mcore1976/antispy-jammer/esp/esp8266-wemos-D1-MINI-PINOUT.png

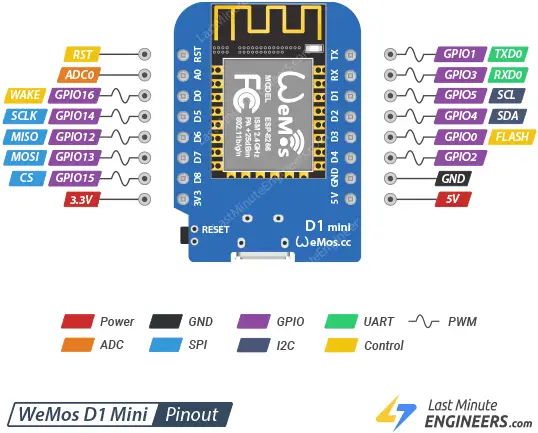
esp/esp8266-wemos-D1-MINI-PINOUT.png
