mcore1976/antispy-jammer/arduino-mic-supresor-ultrasonic-RP2040-zero-PWM-no-AD9833-TC4420-IRF4115-coils.png

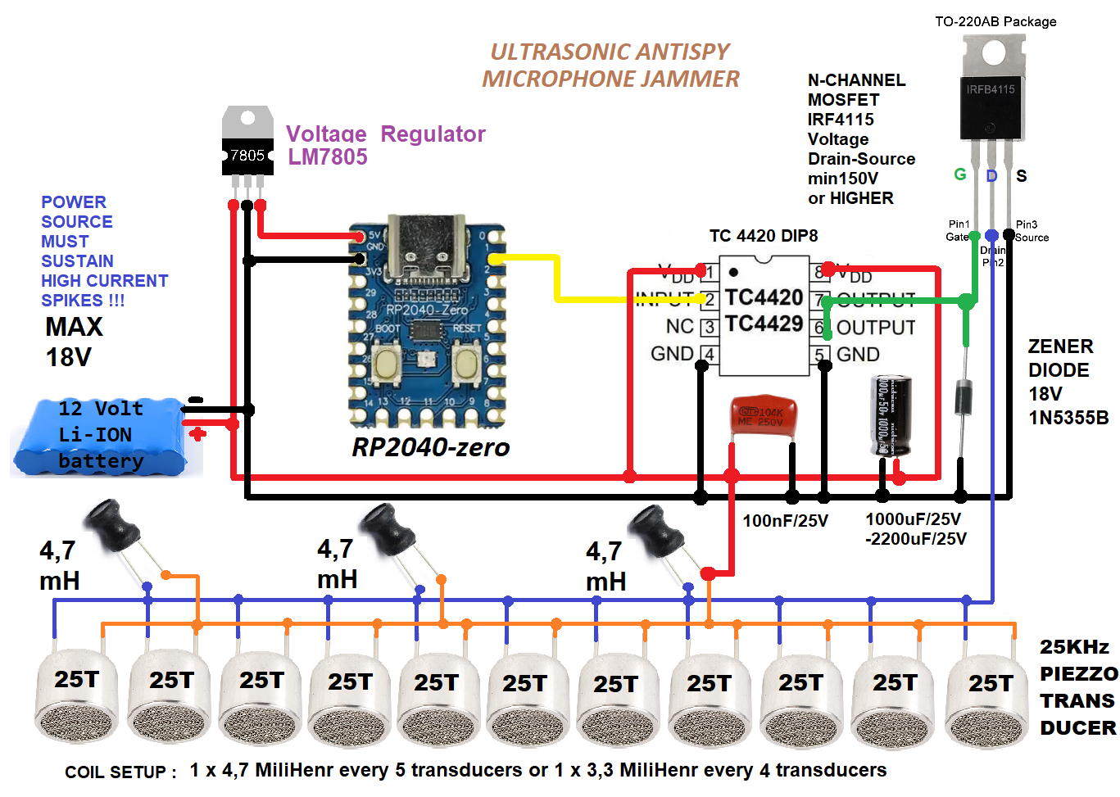
arduino-mic-supresor-ultrasonic-RP2040-zero-PWM-no-AD9833-TC4420-IRF4115-coils.png
