mcore1976/antispy-jammer/antispy-jammer-H-bridge-RP2040-PWM-IR2103-IRF4115-PCB-view.PNG

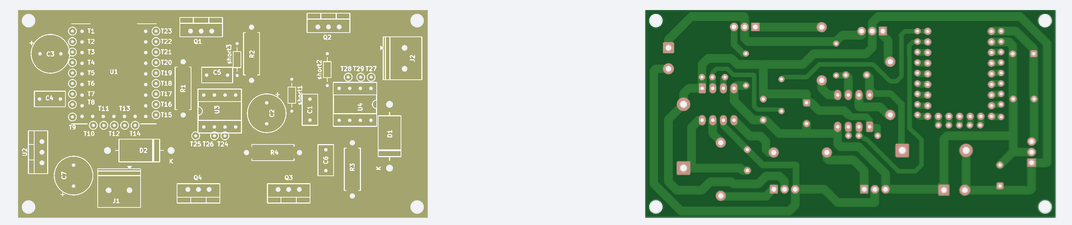
antispy-jammer-H-bridge-RP2040-PWM-IR2103-IRF4115-PCB-view.PNG
