mcore1976/antispy-jammer/antispy-jammer-H-bridge-RP2040-PWM-IR2104-IRF4115.PNG

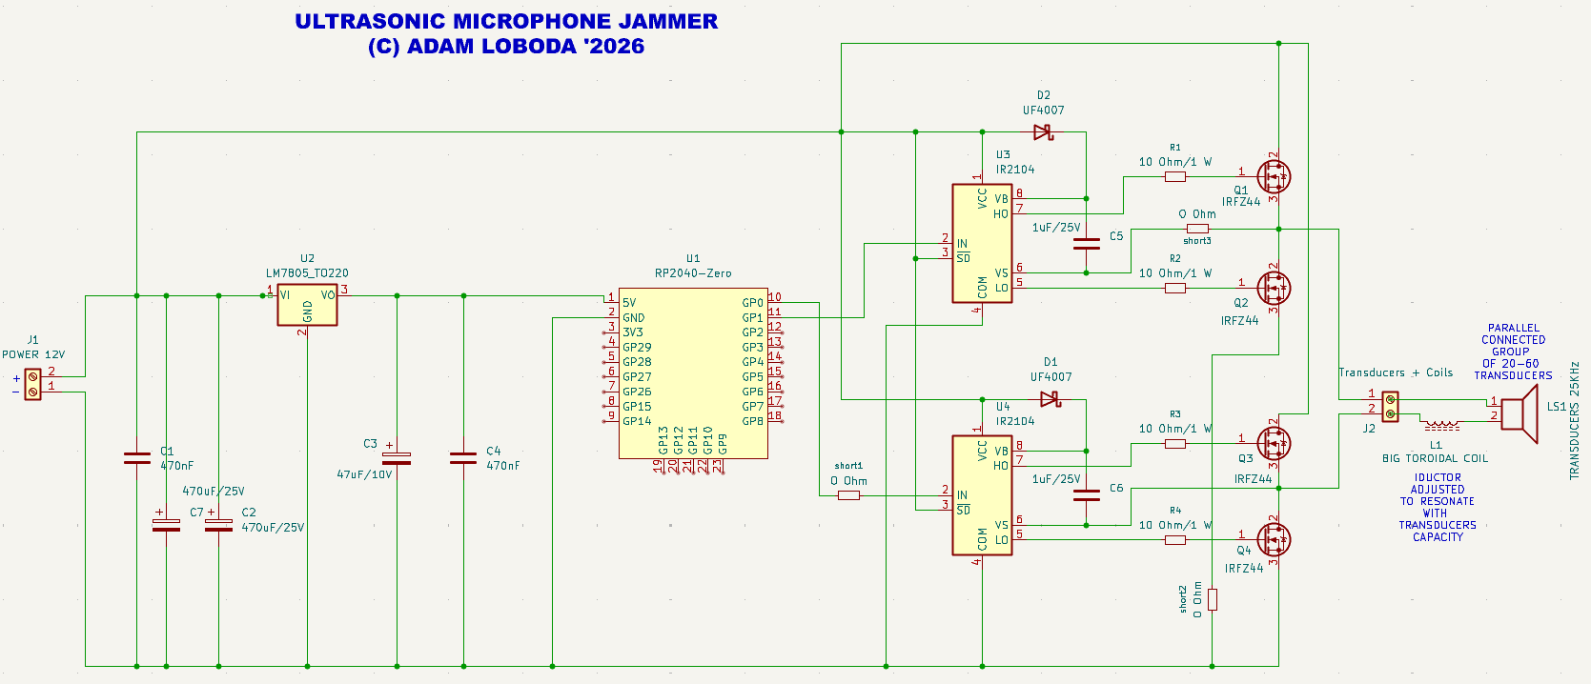
antispy-jammer-H-bridge-RP2040-PWM-IR2104-IRF4115.PNG
