mcore1976/antispy-jammer/arduino-mic-supresor-ultrasonic-RP2040-zero-TC4420-IRF4115-coils.png

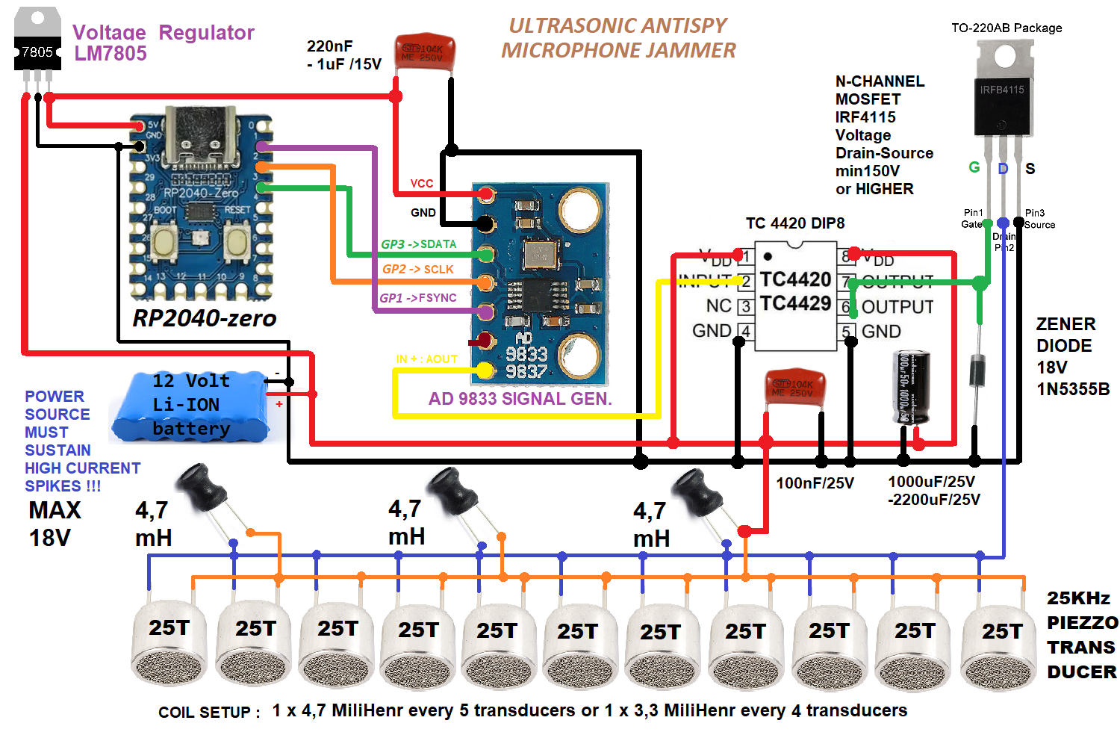
arduino-mic-supresor-ultrasonic-RP2040-zero-TC4420-IRF4115-coils.png
