mcore1976/antispy-jammer/arduino-mic-supresor-ultrasonic-RP2040-zero-TPA3116-IRF-coils.png

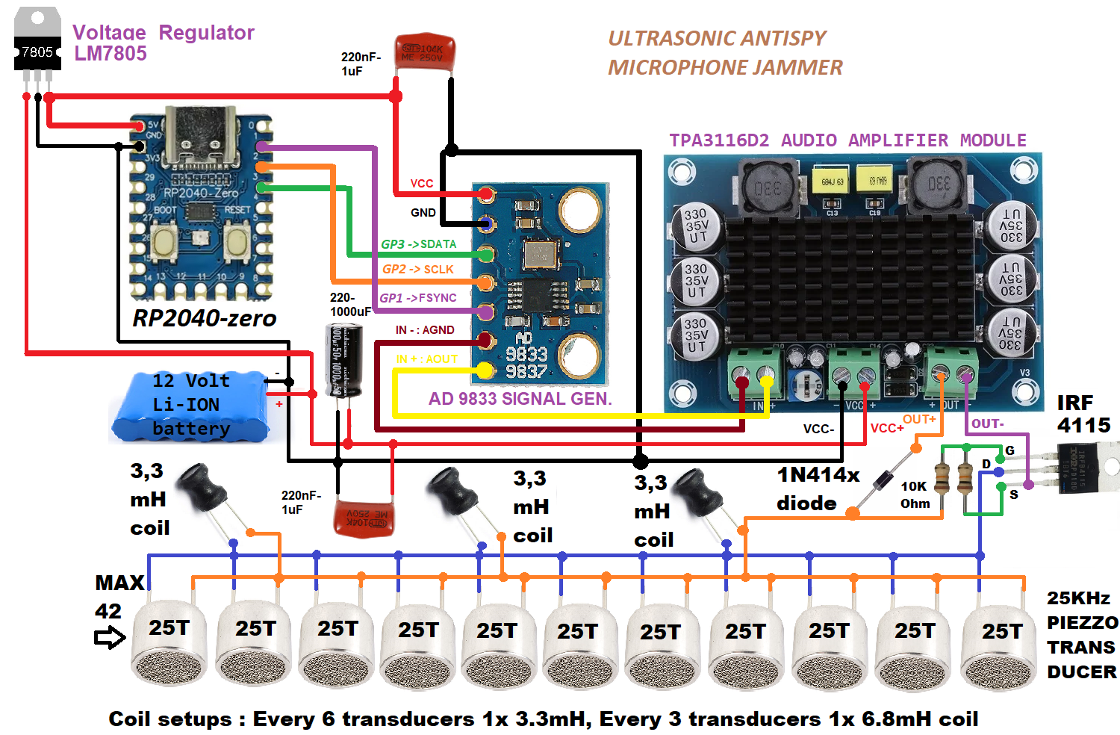
arduino-mic-supresor-ultrasonic-RP2040-zero-TPA3116-IRF-coils.png
