mcore1976/antispy-jammer/arduino-mic-supresor-ultrasonic-RP2040-zero.png

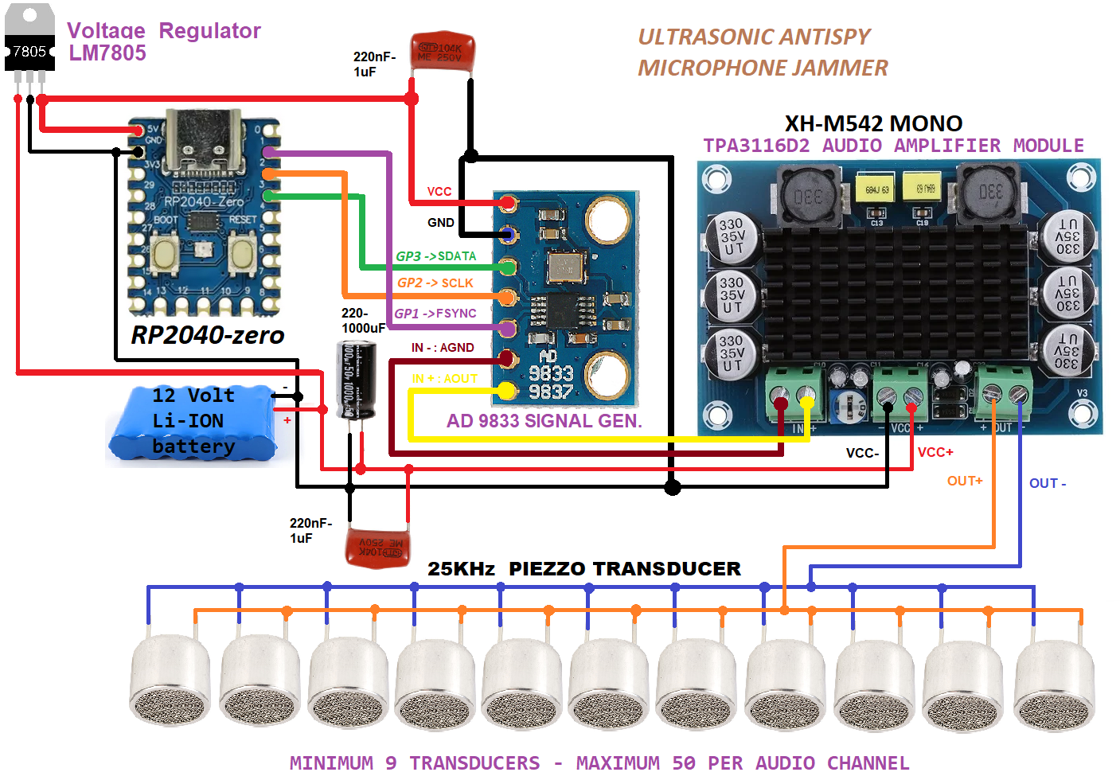
arduino-mic-supresor-ultrasonic-RP2040-zero.png
