mcore1976/antispy-jammer/attiny/antispy-jammer-enhanced-schematic.png

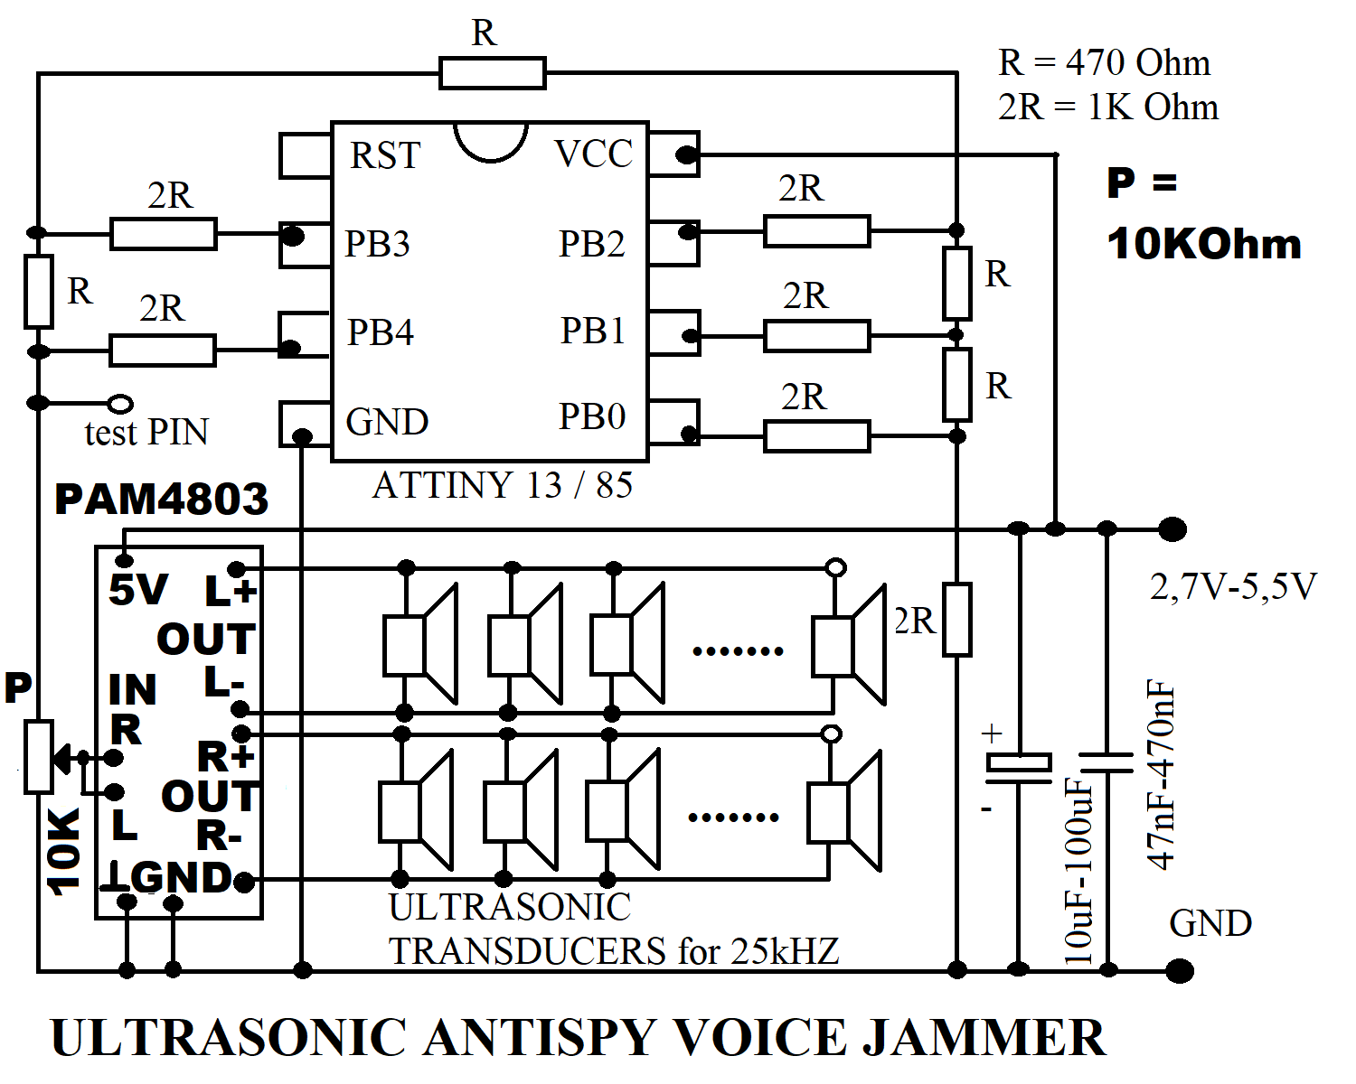
attiny/antispy-jammer-enhanced-schematic.png
