mcore1976/antispy-jammer/attiny/antispy-jammer-schematic.png

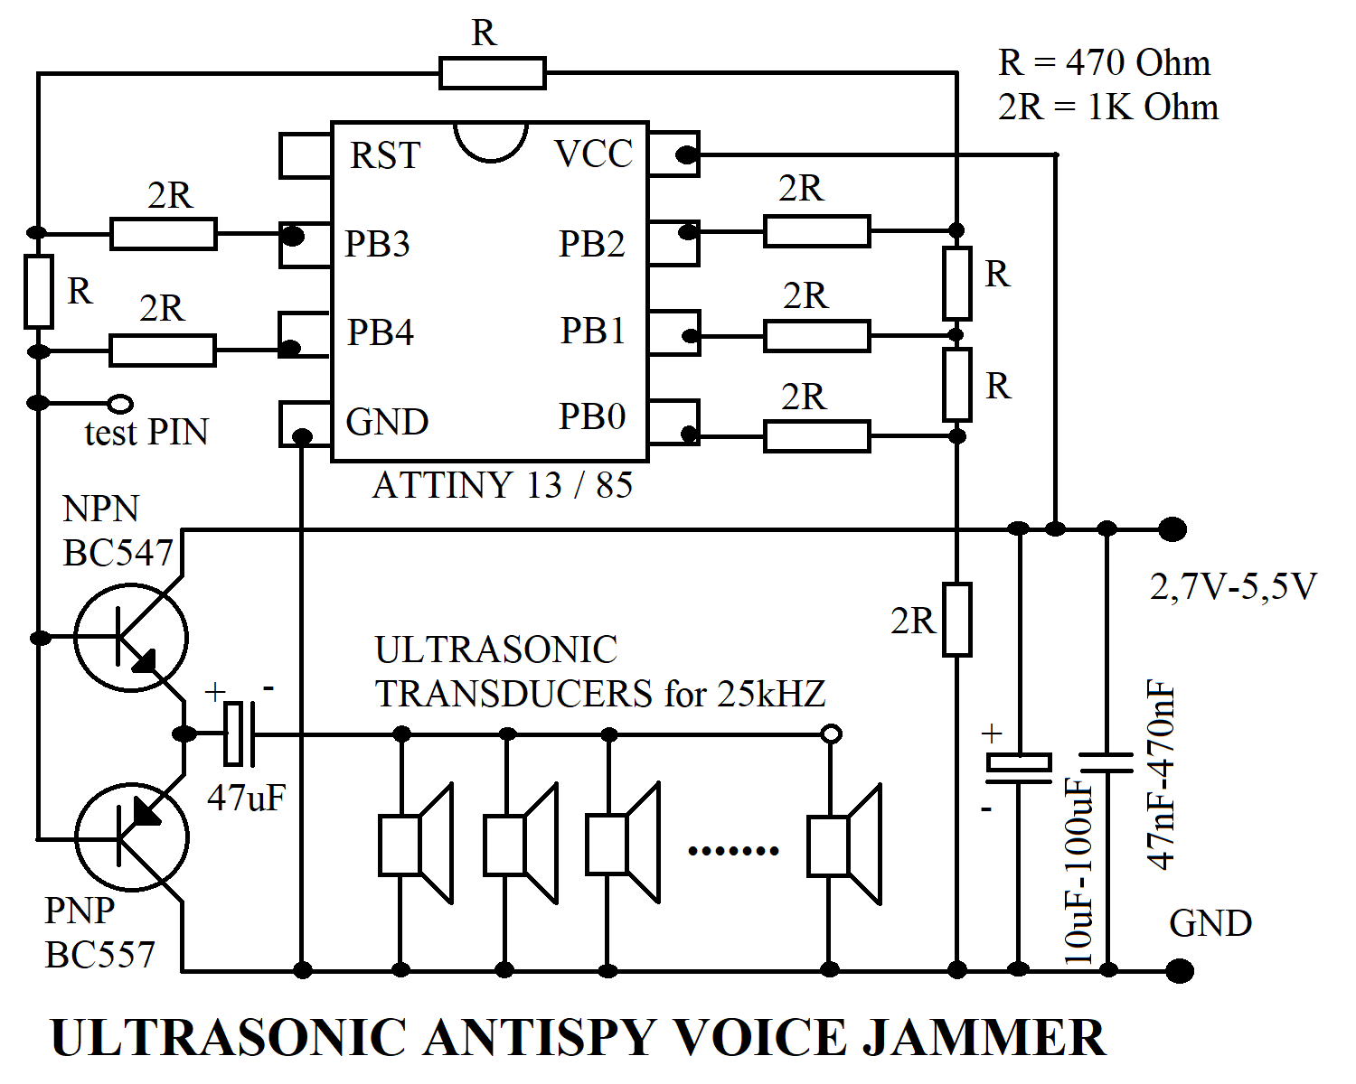
attiny/antispy-jammer-schematic.png
