mcore1976/antispy-jammer/attiny/arduino-mic-supresor-ultrasonic-ATTINY85-TC4420-IRF4115-coils.png

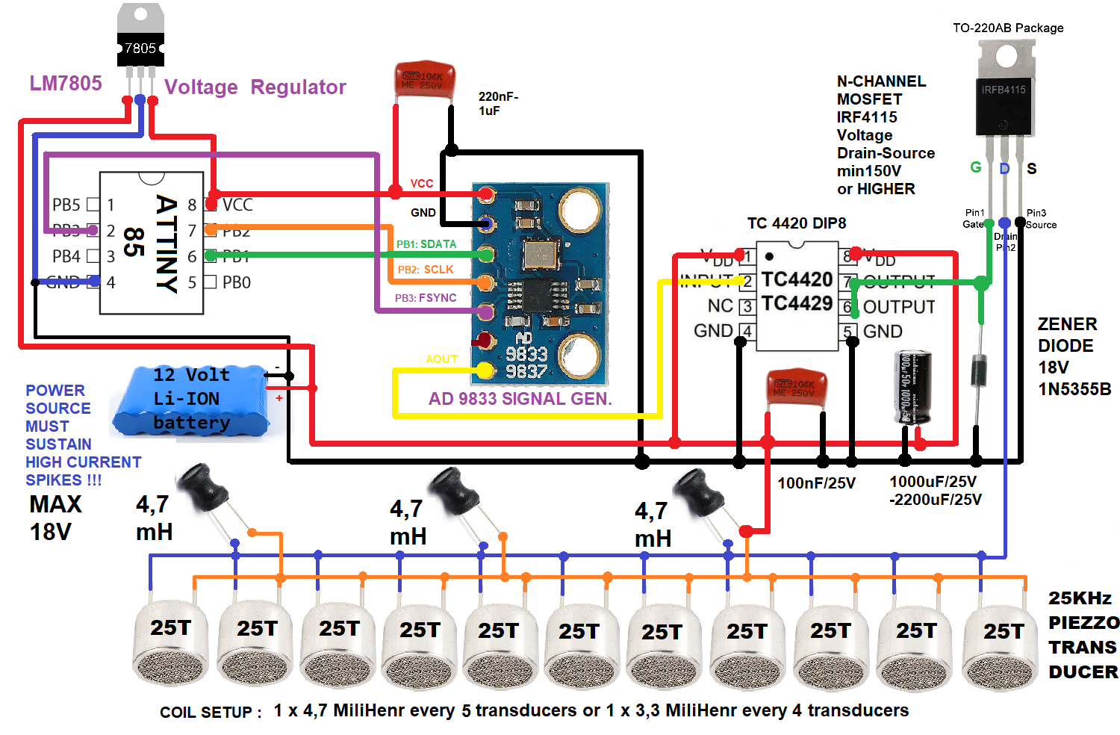
attiny/arduino-mic-supresor-ultrasonic-ATTINY85-TC4420-IRF4115-coils.png
