mcore1976/antispy-jammer/attiny/arduino-mic-supresor-ultrasonic-v2-ATTINY85.png

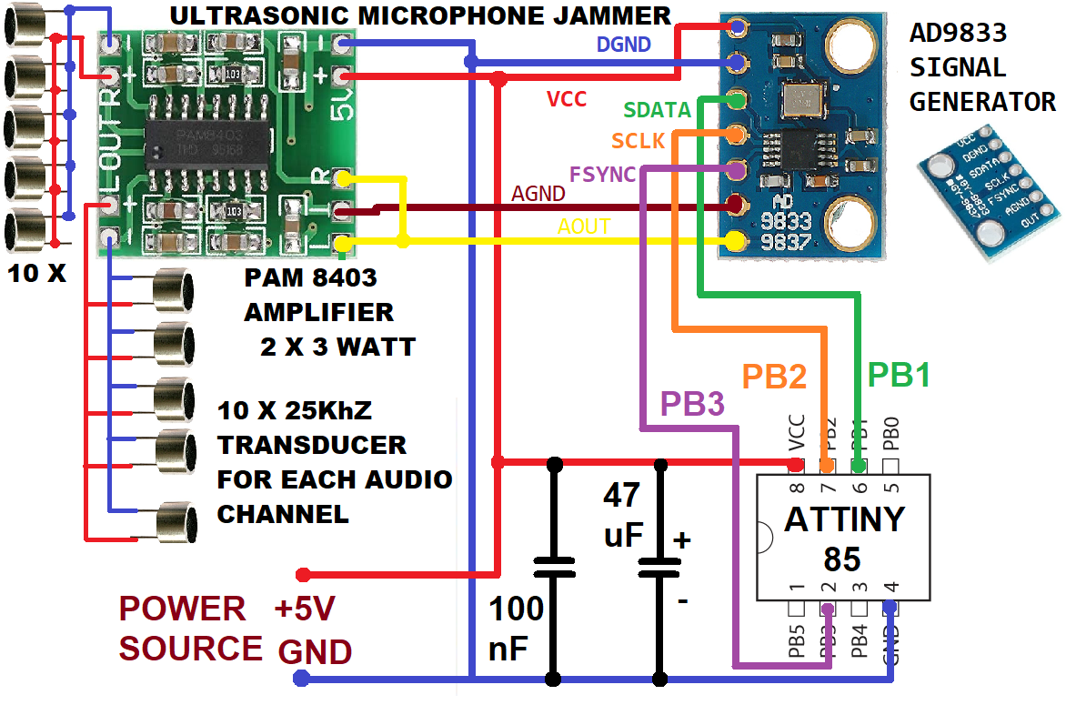
attiny/arduino-mic-supresor-ultrasonic-v2-ATTINY85.png
