mcore1976/antispy-jammer/attiny/arduino-mic-supresor-ultrasonic-v2.png

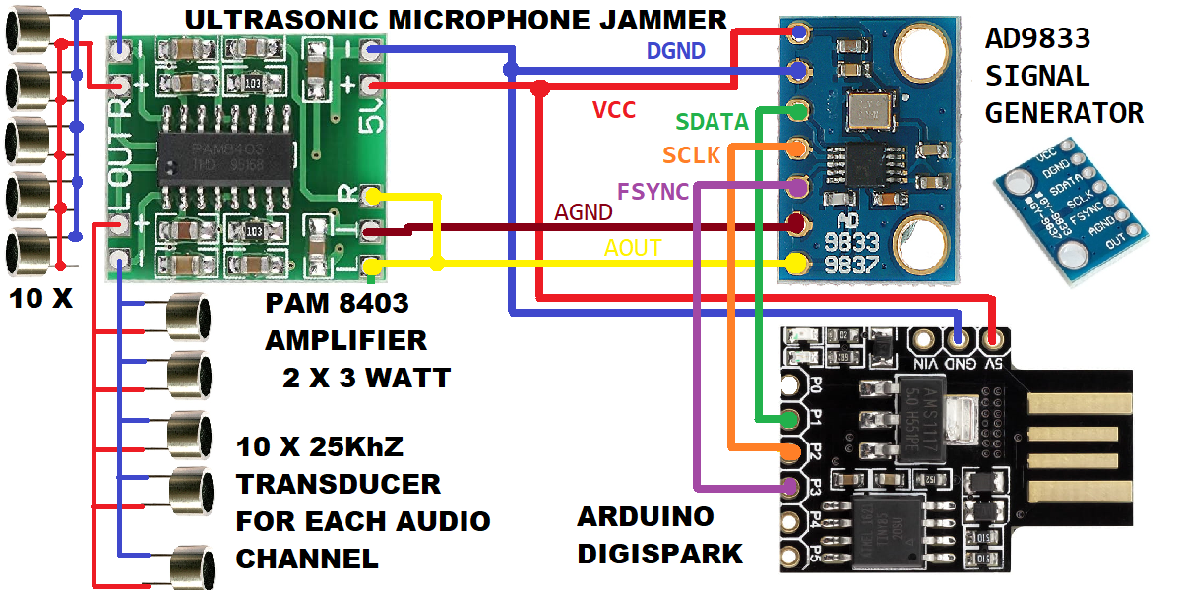
attiny/arduino-mic-supresor-ultrasonic-v2.png
