mcore1976/antispy-jammer/attiny/arduino-mic-supresor-ultrasonic-v3-ATTINY85-TPA3116-IRF-coils.png

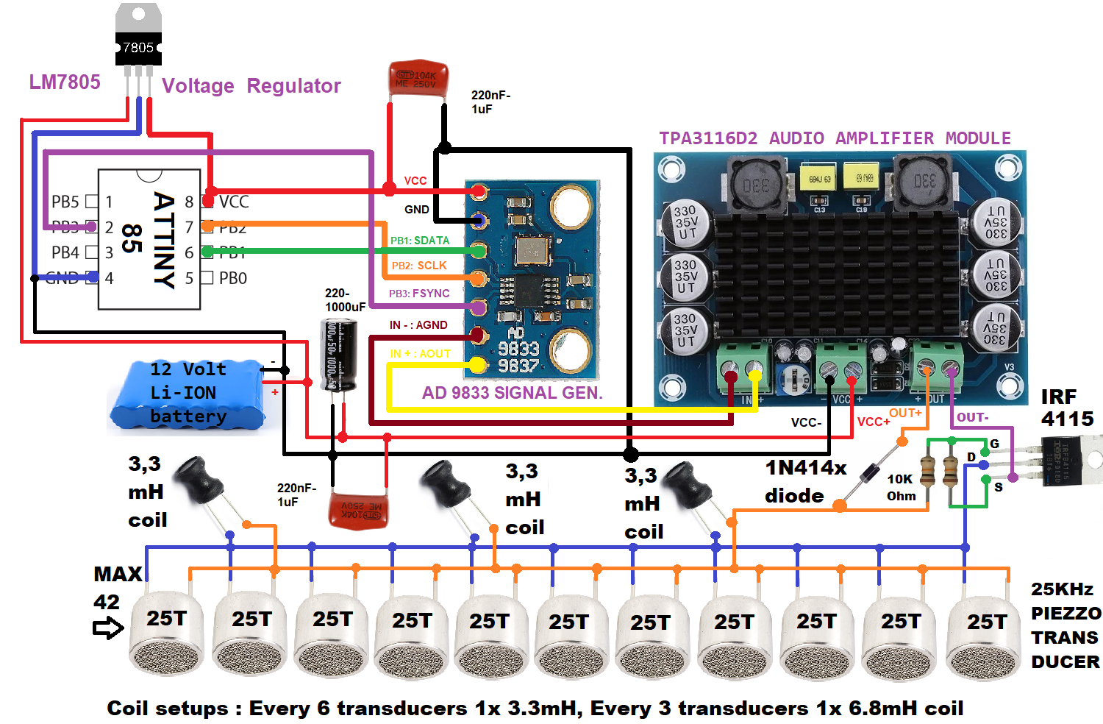
attiny/arduino-mic-supresor-ultrasonic-v3-ATTINY85-TPA3116-IRF-coils.png
