mcore1976/antispy-jammer/attiny/arduino-mic-supresor-ultrasonic.png

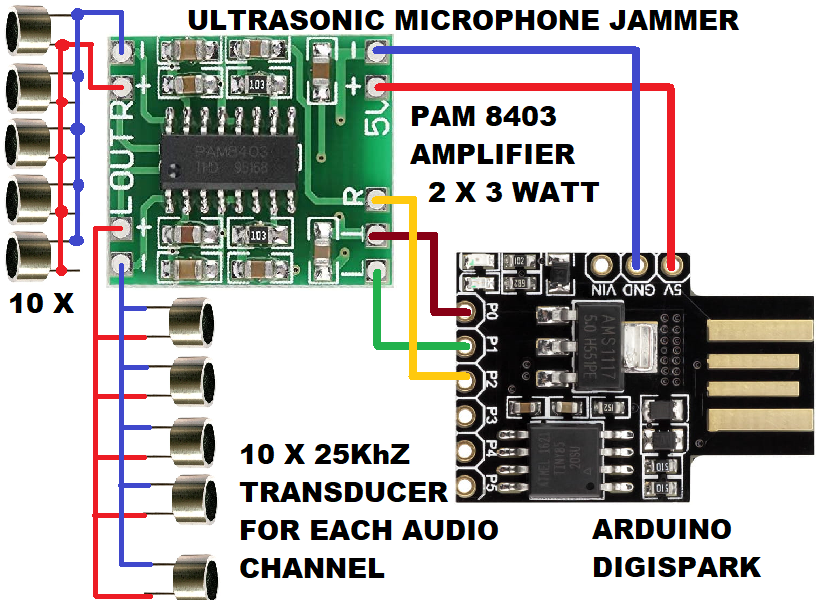
attiny/arduino-mic-supresor-ultrasonic.png
