mcore1976/antispy-jammer/attiny/mic-jammer-AD9833-TPA3116D2-IRF-coils.png

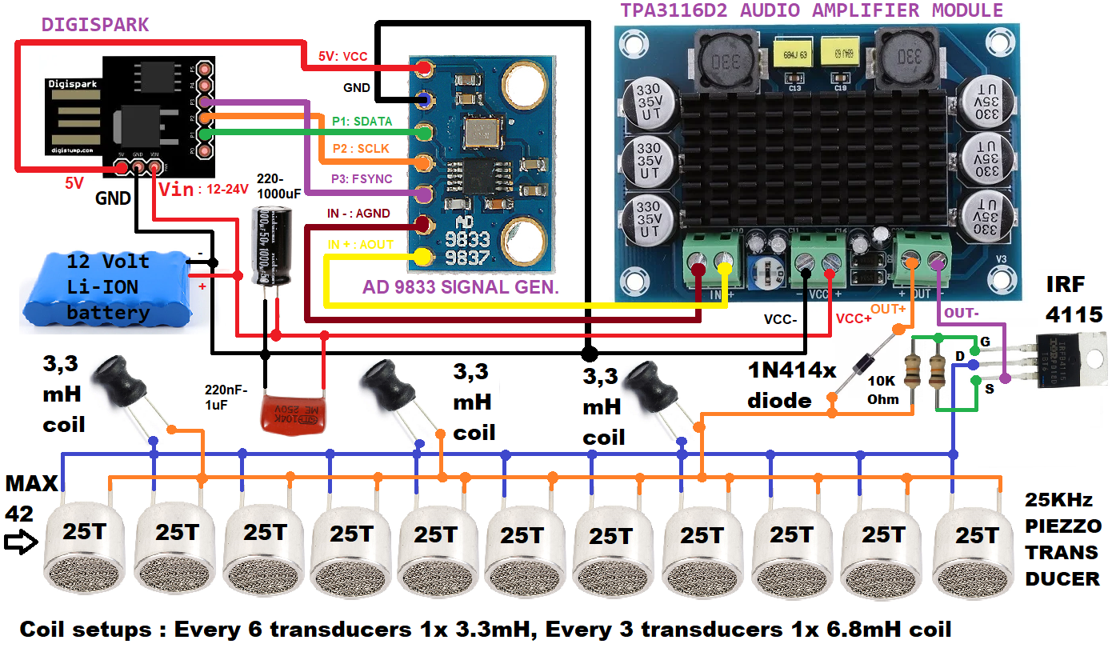
attiny/mic-jammer-AD9833-TPA3116D2-IRF-coils.png
