mcore1976/antispy-jammer/attiny/mic-jammer-AD9833-TPA3116D2.png

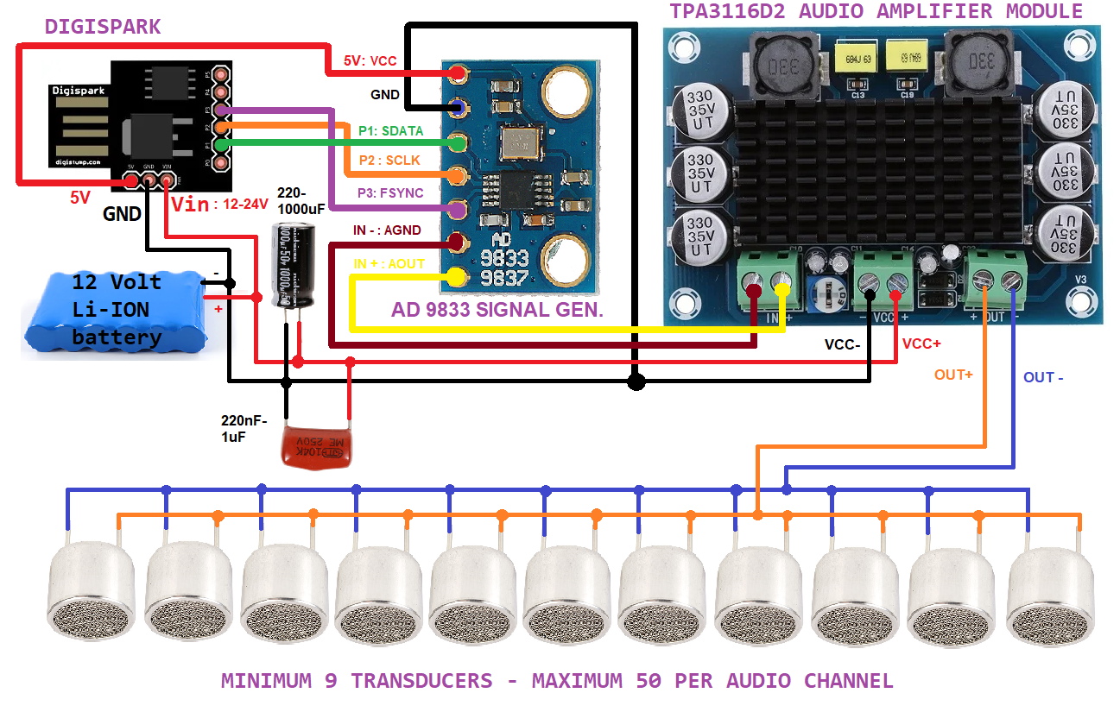
attiny/mic-jammer-AD9833-TPA3116D2.png
