mcore1976/antispy-jammer/attiny/mic-jammer-TPA3116D2.png

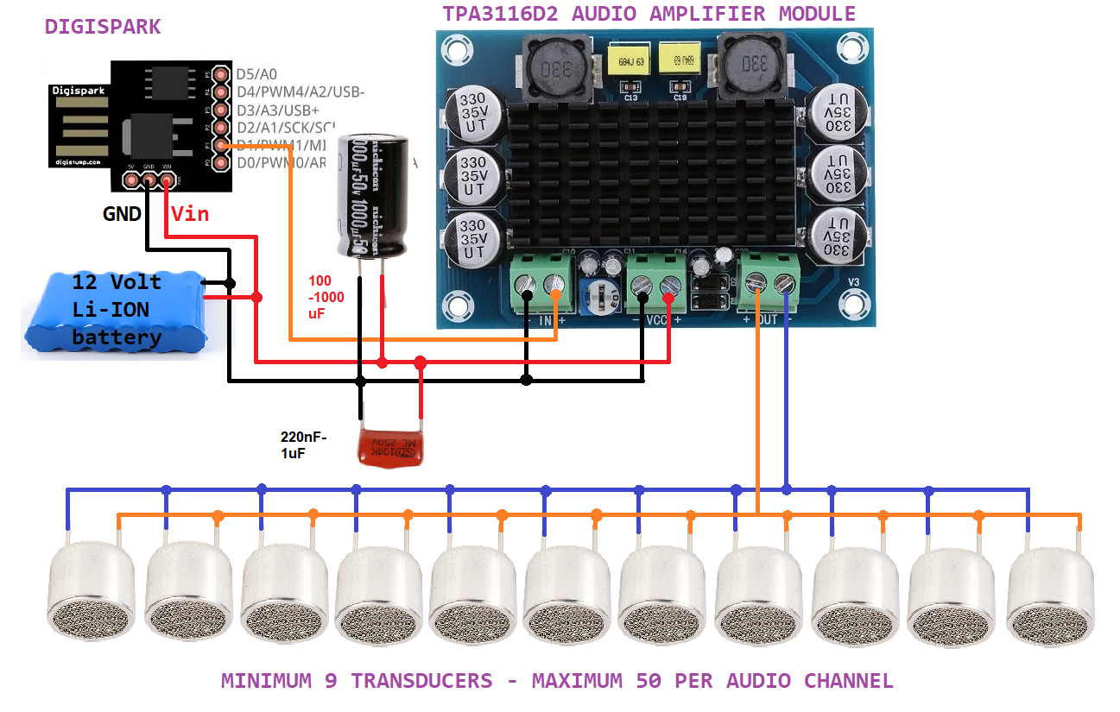
attiny/mic-jammer-TPA3116D2.png
