mcore1976/antispy-jammer/attiny/mosfet-transistor-autotransformer-coil-and-ad9833-digispark-transducers.png

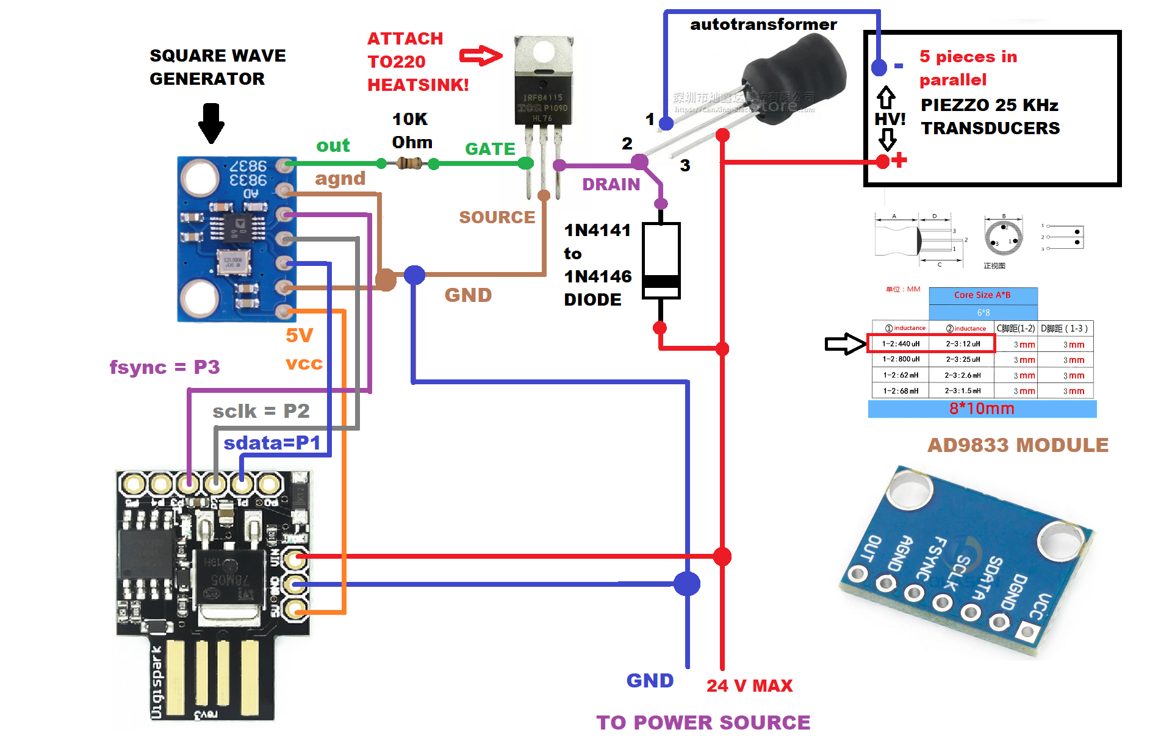
attiny/mosfet-transistor-autotransformer-coil-and-ad9833-digispark-transducers.png
