mcore1976/antispy-jammer/attiny/mosfet-transistor-coil-and-ad9833-digispark-transducers.png

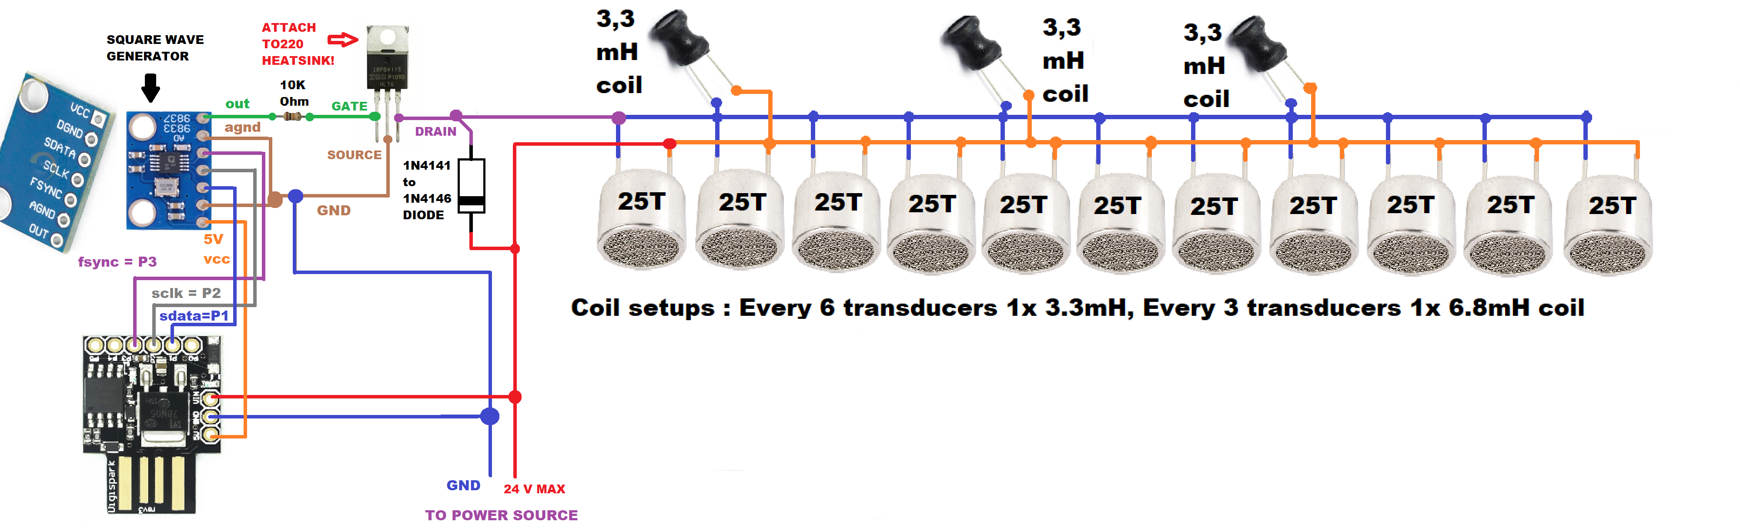
attiny/mosfet-transistor-coil-and-ad9833-digispark-transducers.png
