mcore1976/antispy-jammer/esp/arduino-mic-supresor-ultrasonic-ESP8266-D1-MINI-TPA3116-IRF-coils.png

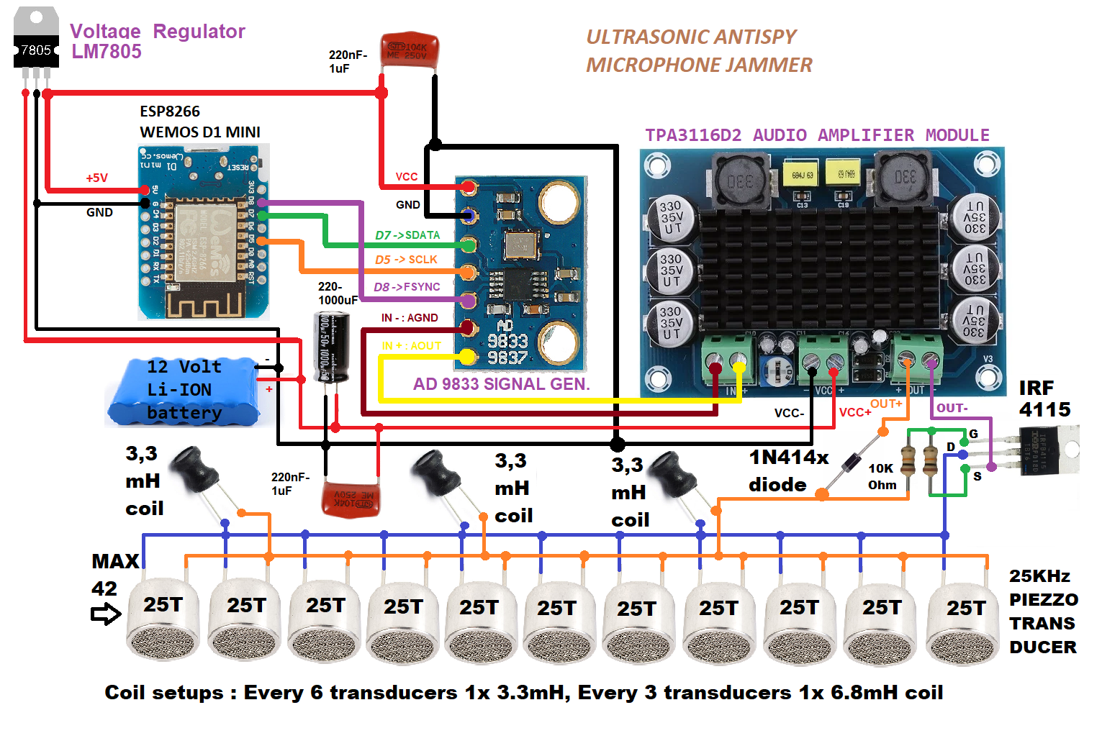
esp/arduino-mic-supresor-ultrasonic-ESP8266-D1-MINI-TPA3116-IRF-coils.png
