mcore1976/antispy-jammer/esp/ESP32-C3-Super-Mini-Pinout-f.png

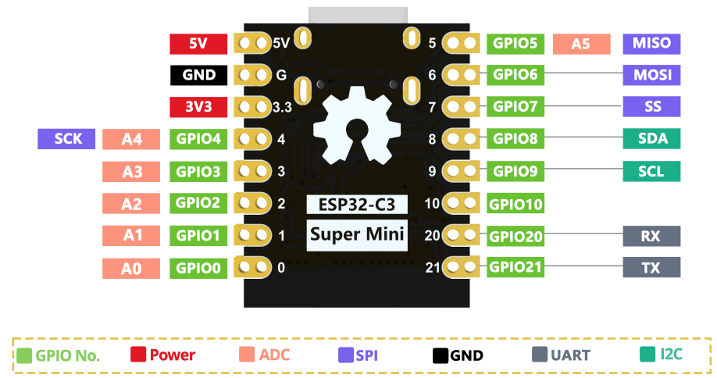
esp/ESP32-C3-Super-Mini-Pinout-f.png
