mcore1976/antispy-jammer/generic/arduino-mic-supresor-ultrasonic-v2-pro-mini.png

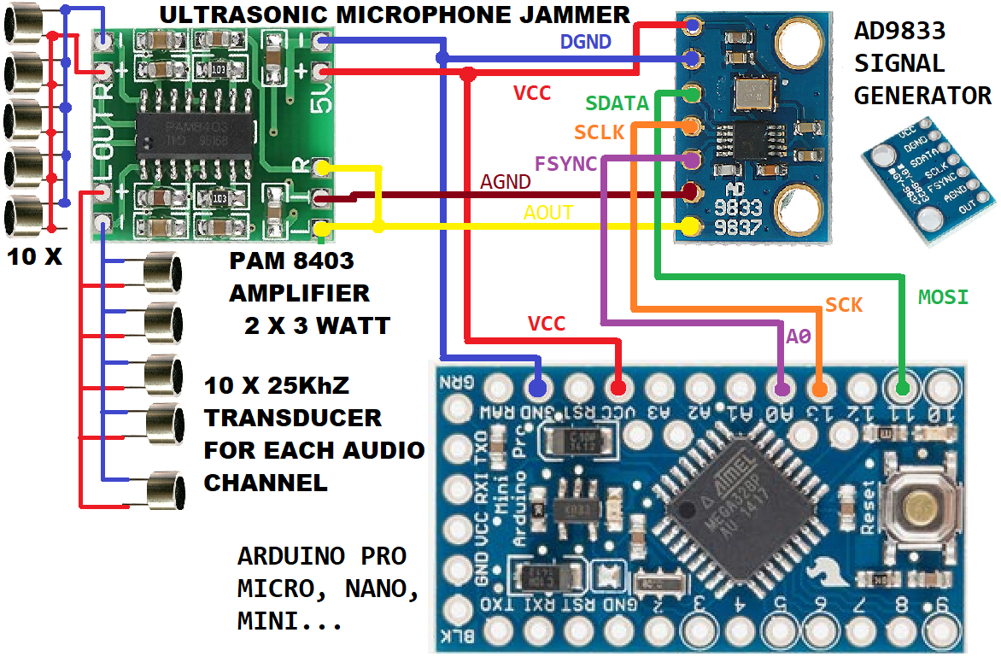
generic/arduino-mic-supresor-ultrasonic-v2-pro-mini.png
