mcore1976/antispy-jammer/(threads)

Thread 1 (2023-08-03):

Ultrasonic jammer

blackrosevn, 2023-08-03:

Closed 2023-08-05.

Thread 5 (2023-12-27):

No effect on recording with chip ATJ2167

darkopop, 2023-12-27:
Thanks for your unselfish work, it is great.

Tested all version , and it works on all mobile phone and recording devices, but I stumbled on device with chip ATJ2167 that have on board condenser microphone and jamming is not successful. Very interesting because it is working on all other devices that I tested .

Best regards , just for your info, I did find chip in

https://www.aliexpress.com/item/1005006371409179.html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

mcore1976, 2023-12-31:
The point is to use the transducers that have bigger tollerance. Normally available transducers are 25 kHz +/- 1KHz. Therefore the code operates within 24KHz-26KHz frequency range.  The source code does FM modulation effect by driving the transducers out of its center frequency in steps while also doing AM type of modulation because if you move out of the center frequency the amplitude of the audio signal gets smaller.
The combination of both techniques FM+AM modulation gives the jamming effect.
IF you want to increase this effect you need to look for the transducers with wider range like 25KHz +/- 2KHz that can operate within 23-27KHz range. You will also need to adapt the code by changing the frequency values respectively.
It is not easy to find such transducers but you may start searching from www.alibaba.com   or  www.made-in-china.com
Check the datasheets from the suppliers and concentrate on 24mm diameter models.

Thread 6 (2024-03-30):

ATTiny connection issues

barrayal, 2024-03-30:
I can't seem to be able to connect properly to the digispark attiny85. and the link you added seems to be dead.
is there a youtube tutorial or something that you would recomend?

mcore1976, 2024-03-31:
try this tutorial for Digispark setuphttps://startingelectronics.org/tutorials/arduino/digispark/digispark-windows-setup/
-------- Oryginalna wiadomość --------Od: barrayal ***@***.***> Data: 30.03.2024  11:39  (GMT+01:00) Do: mcore1976/antispy-jammer ***@***.***> DW: Subscribed ***@***.***> Temat: [mcore1976/antispy-jammer] ATTiny connection issues (Issue #6)
I can't seem to be able to connect properly to the digispark attiny85. and the link you added seems to be dead.
is there a youtube tutorial or something that you would recomend?

—Reply to this email directly, view it on GitHub, or unsubscribe.You are receiving this because you are subscribed to this thread.Message ID: ***@***.***>

barrayal, 2024-04-06:
I've went by the tutorial you suggested and tried the led testing code the have and it's not working.
I see the device light up but if i change the values of the delay the led doesn't change so I think it's not working/
I even bought new ATtiny85 on amazon and it's the same.
I keep getting this:

Sketch uses 718 bytes (11%) of program storage space. Maximum is 6012 bytes.
Global variables use 9 bytes of dynamic memory.
Running Digispark Uploader...
Plug in device now... (will timeout in 60 seconds)
> Please plug in the device ...
> Press CTRL+C to terminate the program.
> Device is found!
connecting: 16% complete
connecting: 22% complete
connecting: 28% complete
connecting: 33% complete
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

can you help?

mcore1976, 2024-04-06:
Hi, The DIGISTUMP page dissapeared and you have to go through following tutorial to setup ARDUINO IDE for ATTINY85 based DIGISPARK :

https://gist.github.com/Ircama/22707e938e9c8f169d9fe187797a2a2c?permalink_comment_id=3561901

Thread 7 (2024-07-18):

My Project is failed

zidanjulio, 2024-07-18:
hello bro I made a design using, Pro micro usb, AD9833, PAM8403, 40Khz. but my project was not successful I want to ask:

1. I did not find pins 11 and 13 on my pro micro module, then I searched the internet about the pro micro schematic. and I replaced them with pins 14,15 as sck and miso. Am I wrong / right?

2. Is there a positive and negative transducer? how to distinguish it, any solution?

mcore1976, 2024-07-31:
First of all please use 25kHz transducers not 40KHz. Also please use TPA3116D2 based audio amplifier not PAM8403 (this one is to o weak).

1. For "original" Arduino Pro micr module here is the link : https://learn.sparkfun.com/tutorials/pro-micro--fio-v3-hookup-guide/hardware-overview-pro-micro
You can find there that it Serial bus uses pins : 15 SCK, 14 MISO, 16 MOSI, for CS you can use any other pin like A10 for example, but you have to declare it in the source code here : https://raw.githubusercontent.com/mcore1976/antispy-jammer/main/mic-jammer-ad9833-new-version2.ino
// Definition of FSYNC , CHIP SELECT pin in Arduino board
#define FNC_PIN A10

2. Yes, the transducers do have polarity. The isolated pin is "+", the one connected to the housing is "-". In general it does not matter but in this case all transducers need to have same pin selected as "+" otherwise the air audio wave will cancel itself due to the phase mismatch

Closed 2025-07-20.

Thread 12 (2025-03-12):

Inquiry About Your DIY Ultrasonic Microphone Jammer Project

oussamaCH20193, 2025-03-12:
Dear JustAnEngineer,

I hope you are doing well.

First of all, I want to sincerely thank you for sharing your work and knowledge. I truly admire your projects and the way you explain them. Your content has been a great source of inspiration for me, as I am very passionate about electronics and signal processing.

Allow me to introduce myself: My name is Oussama Charef, and I am a young engineer from Algeria specializing in networks and telecommunications. I recently followed your video on the "DIY Ultrasonic Microphone Recording Jammer for Android and iPhone" and built my own version, designing a custom PCB. The jammer works quite well on most devices, but I’ve encountered two challenges:

A slight audible hissing sound coming from the ultrasonic emitters.
Reduced effectiveness on recent iPhones: It seems that at a distance of 10 to 15 cm, iPhones are able to detect and filter the ultrasonic signals, making the jammer less effective.
I was wondering if you have encountered similar issues and if there might be a way to optimize the design or modify the code to improve its efficiency, particularly against iPhones.

I have attached images of my prototype and PCB design for reference. I would be truly grateful for any advice or insights you could share.

Thank you again for your amazing work—I really appreciate the time and effort you put into your projects! Looking forward to your response.

Best regards,
Oussama Charef

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

ge](https://github.com/user-attachments/assets/ec37aac1-ef28-4617-b4f9-f9346c0ad4bf)
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

jellyzily, 2025-03-17:
hello im a student from china, i want to know what u use ,linux or windows,because i can't use linux,i can't use the code. i need your help..My English is not very good. Please excuse me. Here I offer my best wishes to you.

jellyzily, 2025-03-17:
joely7144@gmail.com   and   2738292695@qq.com   are  all my email,if u can see my comment and have  time to help me,u can touch me,thank you,best wish to you,and look forward to your reply

mcore1976, 2025-07-20:
Hello Oussama ,
You may want to use additional coils and IRF MOSFET which will enable higher voltage on ultrasonic transducers therefore higher power will be emitted. IRF will serve as additional "voltage key" and is not mandatory. The jamming will have a slightly better effect especially on iPhones, however it may generate noticable sound.

Thread 14 (2025-07-05):

Does not work on some phones

saiddonmez, 2025-07-05:
Hello, I implemented your code and setup with 18 transducers and tried ultrasonic jamming on 3 different phones:

Xiaomi 14,
Xiaomi 12,
Iphone 15,

While it succesfully jammed Xiaomi 12, and Iphone 15,
it couldnt jam the first channel of the microphone in Xiaomi 14 (it kinda succesfully jammed the second channel). The sound was very clear in the first channel and not jammed at all. Do you have any ideas why this is the case, and how to jam Xiaomi 14 microphones?

mcore1976, 2025-07-20:
Yes, the jamming is never 100% successful. some microphones are resistant.
Have you used coils connected to transducers ? Also has IRF MOSFET been used ?  Also you may try to change some settings in the code like :

  // choosing random cut off for gap - you may play with this range
	  x = random**(20,50);**

         // INCREASING FREQUENCY GAP IN INTERVALS - you may play with this range
            j = j + random**(1,5)**; 
           // increasing gap j up to x then from the beginning
          **//**  j = (j + 1) % x;

Thread 15 (2025-09-07):

DIY Ultrasonic Microphone Jammer Project

jhonpohac, 2025-09-07:
Hello friend, excellent work, keep it up, what is the latest version? Which is the best one that works super well and is the most powerful of all? Please tell me.

mcore1976, 2025-09-07:
These are the latest and most powerfule versions. All of them are using AD9833 signal generator and TPS3116D2 audio amplifier module

Raspberry Pi PICO : RP2040-ZERO module
RP2040-ZERO DIAGRAM #1: https://github.com/mcore1976/antispy-jammer/blob/main/arduino-mic-supresor-ultrasonic-RP2040-zero-TPA3116-IRF-coils.png
RP2040-ZERO DIAGRAM #2 https://github.com/mcore1976/antispy-jammer/blob/main/arduino-mic-supresor-ultrasonic-RP2040-zero.png
RP2040-ZERO CODE : https://raw.githubusercontent.com/mcore1976/antispy-jammer/refs/heads/main/mic-jammer-rp2040-ad9833.ino

ESP8266 : WEMOS D1 MINI (clone) module
D1-MINI DIAGRAM #1 : https://github.com/mcore1976/antispy-jammer/blob/main/arduino-mic-supresor-ultrasonic-ESP8266-D1-MINI-TPA3116-IRF-coils.png
D1-MINI DIAGRAM #2 : https://github.com/mcore1976/antispy-jammer/blob/main/arduino-mic-supresor-ultrasonic-ESP8266-D1-MINI.png
D1-MINI CODE : https://raw.githubusercontent.com/mcore1976/antispy-jammer/refs/heads/main/mic-jammer-esp8266-wemos-d1-mini-ad9833.ino

ESP32C3-SUPERMINI  CODE : https://raw.githubusercontent.com/mcore1976/antispy-jammer/refs/heads/main/mic_jammer_esp32c3_supermini_ad9833.ino

ATTINY85  DIAGRAM  :  https://github.com/mcore1976/antispy-jammer/blob/main/arduino-mic-supresor-ultrasonic-v3-ATTINY85-TPA3116-IRF-coils.png
ATTINY85 CODE for AVR-GCC : https://github.com/mcore1976/antispy-jammer/blob/main/main6-new-version4.c

DIGISPARK DIAGRAM #1 : https://github.com/mcore1976/antispy-jammer/blob/main/mic-jammer-AD9833-TPA3116D2-IRF-coils.png
DIGISPARK DIAGRAM #2 : https://github.com/mcore1976/antispy-jammer/blob/main/mic-jammer-AD9833-TPA3116D2.png
DIGISPARK CODE : https://github.com/mcore1976/antispy-jammer/blob/main/mic-jammer-digispark-ad9833-new-version4.ino

jhonpohac, 2025-09-07:
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

Hello friend, thank you very much for responding, but of all of these, which one do you think is the best? Which one works best and is the most powerful? I'm going to make one, but I want to make the most powerful one. Please, do you recommend that I only make one?

Closed 2025-09-07.

Thread 16 (2025-09-19):

-DIAGRAMA-ESP32C3-SUPERMINI

jhonpohac, 2025-09-19:
Hi friend, I can't find the diagram for the esp32 c3 supermini. Can you please send it to me?

I already have the .ino.

the diagram for the esp32 c3 supermini

jhonpohac, 2025-09-21:
HI  Hi friend, I can't find the diagram for the esp32 c3 supermini. Can you please send it to me? HELO...................

mcore1976, 2025-09-21:
I will create the diagram one day, but meanwhile have you looked into the source code ? All the informations are there

Boards needed :
    ESP32C3 Super Mini board - please adjust SPI pin CS numbering
    AD9833 signal generator board
    TPA3116D2 - audio amplifier module + potentiometer

    CONNECTION EXAMPLE FOR ESP32C3 SUPER MINI BOARD
    --------
    AD9833 PCB to ESP32C3 Super Mini :
    SDATA --> pin D6 MOSI  ( GPIO 6 )
    SCLK  --> pin D4 SCK  ( GPIO 4 )
    FSYNC --> pin D7 SS (GPIO 7 )  - adjust this pin  FNC_PIN for you Arduino board down below
    DGND  --> GND
    VCC   --> VCC

    AD9833 PCB to TPA3116 AUDIO AMPLIFIER
    AOUT  --> LEFT AUDIO IN + RIGHT AUDIO IN
    AGND  --> AUDIO GND

    REMEMBER TO CONNECT AD9833 TO 5V AND GND PINS OF ARDUINO BOARD
    ARDUINO HAS TO BE POWERED FROM 12V THROUGH Vin PIN
    TPA3116 HAS TO BE CONNECTED TO 12V AND GND

jhonpohac, 2025-09-21:
> REMEMBER TO CONNECT AD9833 TO 5V AND GND PINS OF ARDUINO BOARD
> ARDUINO HAS TO BE POWERED FROM 12V THROUGH Vin PIN
> TPA3116 HAS TO BE CONNECTED TO 12V AND GND

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

jhonpohac, 2025-09-21:
Amigo un croquis a si sea a lapiz por favor  mi correo es jhonpo@gmail.com

jhonpohac, 2025-09-21:
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

Un croquis a si sea a lápiz por favor

Closed 2025-09-21.

Thread 17 (2025-09-21):

-DIAGRAMA-ESP32C3-SUPERMINI

jhonpohac, 2025-09-21:
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

mcore1976, 2025-09-21:
Here are the diagrams for the ESP32C3 SUPERMINI board

https://github.com/mcore1976/antispy-jammer/blob/main/arduino-mic-supresor-ultrasonic-esp32c3-supermini-TPA3116-IRF-coils.png

https://github.com/mcore1976/antispy-jammer/blob/main/arduino-mic-supresor-ultrasonic-esp32c3-supermini.png

Closed 2025-09-21.

Thread 18 (2025-09-22):

With these materials I can make that diagram?

jhonpohac, 2025-09-22:
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

 _Originally posted by @jhonpohac in [#17](https://github.com/mcore1976/antispy-jammer/issues/17#issuecomment-3316480016)_

jhonpohac, 2025-09-25:
> Sí, necesitas al menos 10 transductores de 25T. Con 1 transductor no funcionará.

si yo tengo los 10

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
