mcore1976/antispy-jammer/attiny/main7.c

/*
 * Antispy ultrasonic device for preventing voice recording 
 * with ultrasonic waves generation based on ATTINY85,
 * ATTINY85 fuses have been set to internal PLL clock 16MHz 
 * with Resistor Ladder 5-bit Digital-to-Analog converter
 * and piezzo-electric driver
 * (C) Adam Loboda 2021, adam.loboda@wp.pl
 */

#include <stdint.h>
#include <util/delay.h>
#include <stdbool.h>
#include <avr/io.h>
#include <avr/pgmspace.h>

// PIN - PORT ASSIGNMENT DEFINITION FOR 5-BIT DAC DEVICE
#define	OUTPUTPORT		PORTB
#define	OUTPUTPORTCTRL		DDRB

 
// created in Excell / Libreoffice - will randomly 
// swing pulse width to achieve noise effect around the center 25kHz frequrency
const uint8_t  randompwm[] PROGMEM = 
  {
20,50,60,69,44,24,49,27,36,58,45,47,68,53,63,62,46,66,70,19,41,32,67,19,38,35,55,60,22,68,29,24,64,
29,55,19,12,30,32,36,21,46,63,32,42,11,58,38,21,46,40,39,65,28,16,42,54,63,24,19,40,18,40,19,36,16,
40,43,37,41,58,25,52,40,61,70,65,16,28,50,30,11,19,31,10,23,30,10,68,30,36,59,66,38,47,68,23,46,51,
39,46,25,31,45,64,49,22,21,13,51,19,64,69,21,59,22,40,32,67,28,31,37,10,61,39,41,48,17,70,53,11,39,
19,66,29,60,49,24,46,27,64,56,33,66,70,51,49,38,14,60,58,39,65,67,34,48,34,14,26,21,47,58,57,38,36,
37,21,17,47,63,63,63,44,54,12,48,29,57,70,35,10,59,22,20,23,26,48,22,64,70,23,40,17,51,16,46,13,51,
53,22,17,59,52,59,36,53,47,25,30,63,19,20,10,19,51,65,22,41,47,55,23,51,68,32,34,70,10,69,41,20,42,
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


        // SET OUTPUT PIN ON ALL OUTPUT PORTS
        
        OUTPUTPORTCTRL = 0b00011111;  //set all 5 LOWER bit pins as output
        OUTPUTPORT     = 0b00000000;  //set all 5 LOWER bit pins to ZERO

       //* neverending loop */
       while (1) 
       { 


          // introduce random delay
           // pulsewidth is up to 10 cycles of wave 
           pulsewidth =  pgm_read_byte(randomdelay + (sequence >> 0x02));
           for(i=0; i<pulsewidth; i++)
                  {
                        asm volatile (
                                        "    nop	\n" 
                                     );

                  };  // end of random delays

          // generating WAVE on BIT0-BIT5 DAC outputs
          // 48 = 27,2 kHZ, added values (0-10) to drop randomly within 23-27kHz frequency
          // random values are taken from PROGMEM lookup table, step is 0,4 kHZ

          for(sequence=0; sequence<4096; sequence++)
           {
           // calculate pulse width 
           pulsewidth = pgm_read_byte(randompwm + sequence);
           // take random amplitude from lookup table, notice there are only 1024 values 
           // so we bit shift right the counter
           amplitude =  pgm_read_byte(randomampl + (sequence >> 0x02));

             // sending a bulk of pulses with defined pulsewidth
             // you may play with number of pulses for better effect of jamming
             for(bulk=0; bulk<25; bulk++)
             {
              // send amplitude level to DAC 
              OUTPUTPORT = amplitude; 
                                 
              // now delay to achieve desired frequency
              for(i=0; i<pulsewidth; i++)
                  {
                        asm volatile (
                                        "    nop	\n" 
                                     );
                  };
              //
              // send LOW VOLTAGE - this time square wave
              OUTPUTPORT = 0; 
              // now delay to achieve desired frequency
              for(i=0; i<(85-pulsewidth); i++)
                  {
                        asm volatile (
                                        "  nop	\n" 
                                     );
                  };
            // End of 'bulk' loop
            };
            
           // end of 'sequence' loop;
          };
          
        }; // neverending loop 

};  // end of MAIN
