mcore1976/antispy-jammer/attiny/mic-jammer-40KHZ.ino

/*
 * Antispy ultrasonic device for preventing voice recording 
 * with ultrasonic waves generation based on ARDUINO DIGISPARK,
 * connections : 
 * PAM8403 module AUDIO LEFT INPUT connected to Port 2 of DIGISPARK
 * PAM8403 module AUDIO RIGHT INPUT connected to Port 1 of DIGISPARK
 * PAM8403 module AUDIO GROUND INPUT connected to Port 0 of DIGISPARK
 * 10 piezzo-electric ultrasonic transducers connected in parallel to PAM8403 OUTPUT LEFT
 * 10 piezzo-electric ultrasonic transducers connected in parallel to PAM8403 OUTPUT RIGHT
 * THIS IS 40 KHZ VERSION !!!
 * (C) Adam Loboda 2021, adam.loboda@wp.pl
 */

#include <stdint.h>
#include <util/delay.h>
#include <stdbool.h>
#include <avr/io.h>
#include <avr/pgmspace.h>

// PIN - PORT ASSIGNMENT DEFINITION FOR OUTPUT
#define  OUTPUTPORT        PORTB
#define  OUTPUTPORTCTRL    DDRB

// created in Excell / Libreoffice - will randomly 
// swing pulse width to achieve noise effect around the center 40 KHz frequrency
const uint8_t  randomized[] PROGMEM = 
  {
9,36,31,23,9,11,18,15,34,23,34,42,40,39,25,16,39,10,44,34,13,37,15,14,26,
10,17,39,37,22,8,35,23,21,40,17,20,9,23,35,38,20,26,40,22,25,7,36,15,28,
29,15,9,32,7,39,20,35,24,12,18,36,14,38,42,42,24,34,16,25,36,12,12,44,44,
27,32,30,38,38,15,37,30,12,29,27,7,15,26,27,21,14,19,27,42,15,24,10,26,28,
33,14,22,21,21,37,14,25,16,38,39,25,37,28,38,27,43,38,7,44,17,12,29,18,28,
8,17,14,38,39,29,39,43,17,16,29,10,26,11,27,35,16,8,13,44,17,36,14,22,12,
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
          // are used to achieve random PWM effect
          
          for(sequence=0; sequence<4096; sequence++)
           {
           // take pulse width from lookup table 
           pulsewidth = pgm_read_byte(randomized + sequence);

             // sending a bulk of pulses with defined pulsewidth 
             // you may play with number of pulses for better effect of jamming
             // (value 40 means every 1/1000 seconds there will be change
             // in the signal shape )
             for(bulk=0; bulk<40; bulk++)
             {
              // send HIGH VOLTAGE - this time square wave
              // PB0 may serve as GND for PAM8403 module audio input
              OUTPUTPORT = 0b00000110; 
                                 
              // now delay to achieve desired frequency
              for(i=0; i<pulsewidth; i++)
                  {
                        asm volatile (
                                        "    nop  \n" 
                                     );
                  };
              //
              // send LOW VOLTAGE - this time square wave
              OUTPUTPORT = 0;               
              // now delay to achieve desired frequency
              // this value 53 determines center frequency of transducers 
              // which is 40KHZ in this version of the code
              for(i=0; i<(53-pulsewidth); i++)
                  {
                        asm volatile (
                                        "  nop  \n" 
                                     );
                  };
            // End of 'bulk' loop
            };
            
           // end of 'sequence' loop;
          };
          
// end of LOOP
}
