mcore1976/antispy-jammer/(commit log)

2024-05-26 Add files via upload
    added resistor for IRF 4115
2025-08-11 Add comments about using different Arduino boards than Digispark
2025-09-21 Added ESP32C3 supermini connection diagrams
2025-11-09 Update README.md
    added TC4420 + IRF 4115 + coils + transducers diagrams for RP2040, ESP8266, ESP32C3
2025-12-30 Add files via upload
    Added Arduino Mini version
2026-03-15 Add files via upload
    Added Zener Diode 18V : 1N5355B for IRF4115B protection from overvoltage ( ESD ) between Gate-Source pins. Ugs is max 20V for MOSFET IRF 4115B
2026-04-28 Add files via upload
    works when you bypass AD9833 module. Take out AD9833 module and connect directly pin #1 ( GP1 output ) of RP2040 to INPUT pin of TC4420 mosfet driver
2026-04-29 Add files via upload
    For new PWM code & RP2040
2026-04-29 Update README.md
    RP2040 no PWM option added
2026-04-30 Add files via upload
    Achieved best jamming effect through linear AM modulation (changing PWM cycle duty in the range 25-35) along with FM sweep
2026-05-02 Add files via upload
    PWM duty cycle swipe tailored for TC4420 chip
2026-05-02 Add files via upload
    Less audible version, PWM duty cycle set to 35%, no AM modulation, only FM modulation
2026-05-03 Add files via upload
    GERBER files for PCBWAY / JCLPCB for the jammer with RP2040 + TC4420 + IRF4115 + PWM option.
2026-05-03 Add files via upload
    KICAD design files for PCBWAY / JCLPCB for the jammer with RP2040 + TC4420 + IRF4115 + PWM option.
2026-05-04 Add files via upload
    KICAD schematic and PCB + GERBER files for JCLPCB / PCBWAY
2026-05-04 Update mic-jammer-rp2040-PWM-v2.ino
    updated delaymicroseconds for completely silent jamming
2026-05-04 Update mic-jammer-rp2040-PWM-v3.ino
    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
2026-05-04 Update mic-jammer-rp2040-PWM-v4.ino
    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
2026-05-10 Add files via upload
    Full H-bridge version with IR2104 half bridge controller chips, shottky diodes & capacitors , MOSFETs IRRFZ44N
    PCB is ready for ordering inb PCBWAY / JCLPCB with attached GERBER zip file
2026-05-10 Add files via upload
    New version with H-bridge for better effectiveness - uses 4 MOSFETS + 2 x IR2104 chip + shottky diodes and additional resistors and capacitors.
    RP2040 is used to steer H-bridge with two signals negative and positive
2026-05-10 Add files via upload
    Added Dead-time function not to break MOSFETs
2026-05-11 Add files via upload
    Calculated 25% of dead time will ensure LC circuit unload high voltage safely
2026-05-11 Add files via upload
    dead time 50% of cycle to completely unload high voltage from LC circuit
2026-05-23 Add files via upload
    corrected schematic and PC for H-Bridge version with RP2040 / IR2104
2026-05-23 Add files via upload
    Fixed PCB for H-Bridge with IR2104 / RP2040
2026-05-31 Update antispam-jammer-H-Bridge-RP2040-PWM-IR2104-IRF4115-v3-dead-time.ino
    Adjusting H-Bridge Dead Time divider
2026-06-02 Add files via upload
    UF2 to program the board over USB / BOOT keypress
2026-06-02 Add files via upload
    70% PWM duty
2026-06-10 Add files via upload
    GERBER & KICAD files for Counterfeit IR2104 chips - which are in fact IR2103 ( you have to short pins 2 & 3 in each of fake IR210x chips)
2026-06-20 PWM cycle duty 70% for high LC voltage, 35 microsecond interval for freq change
2026-06-28 Change jamming range 25KHz +/- 250Hz and additional randomization FM/AM
2026-06-29 Change jamming range 25KHz +/- 350Hz and additional randomization FM/AM
2026-07-13 New approach to jamming. completely not audible, the "chopper" version which tricks AGC in smartphones
    [mic-jammer-rp2040-PWM-v14.ino]
2026-07-15 New approach to jamming. Chopper style overload of Automatic Gain Control in the smartphones. Barely audible to humans
    [mic-jammer-rp2040-PWM-v14.ino]
